Haellsigh/Bluetrackr/README.md

# Bluetrackr

Bluetrackr is a head tracking device. It allows you to track your head orientation & position in realtime. It's mainly used in games such as Elite Dangerous, Star Citizen, Flight simulators, etc to simulate head movement in a cockpit.

## Progress
prototype-v1: There was an unknown problem with the SPI bus. Might be because there are two devices on the same SPI bus?
prototype-v2: Ordered, waiting for parts.

Everything below is for v2.

### Transmitter schematic:



### Transmitter PCB:

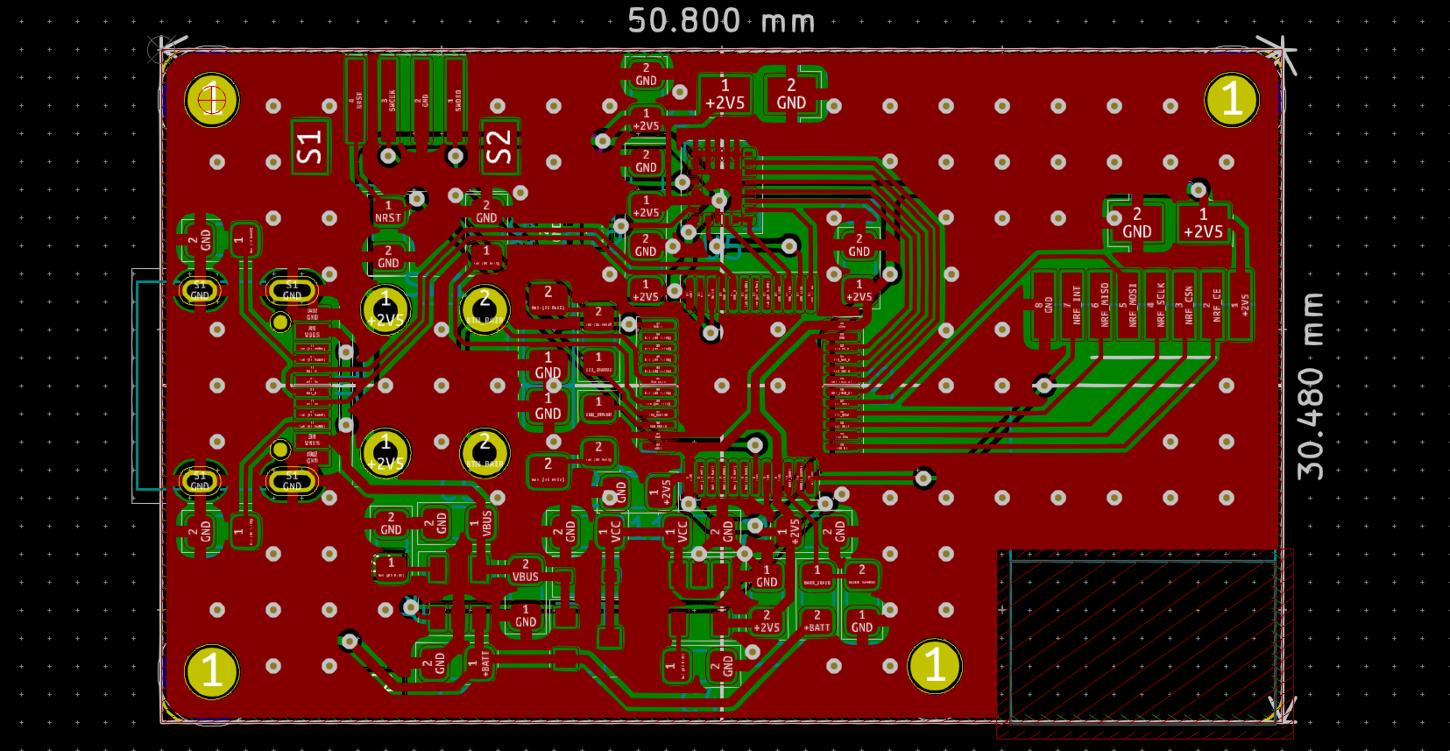
[picture p1: doc/images/Bluetrackr-transmitter-pcb.png]


### Transmitter PCB 3D view:

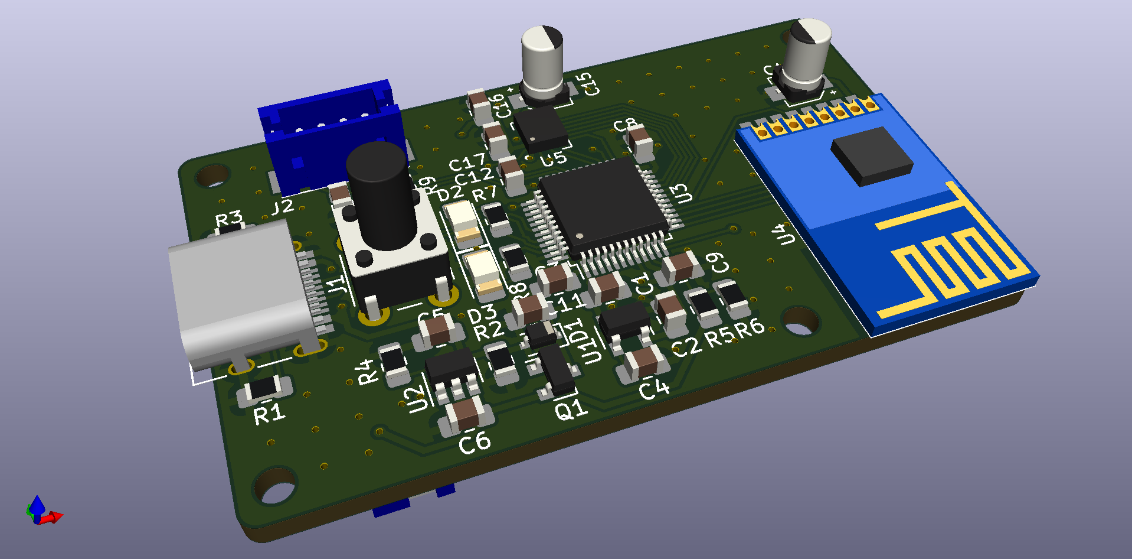
[picture p2: doc/images/Bluetrackr-transmitter-3d.png]


## Prototypes

#### Soldered prototype-v1
<p align="center">
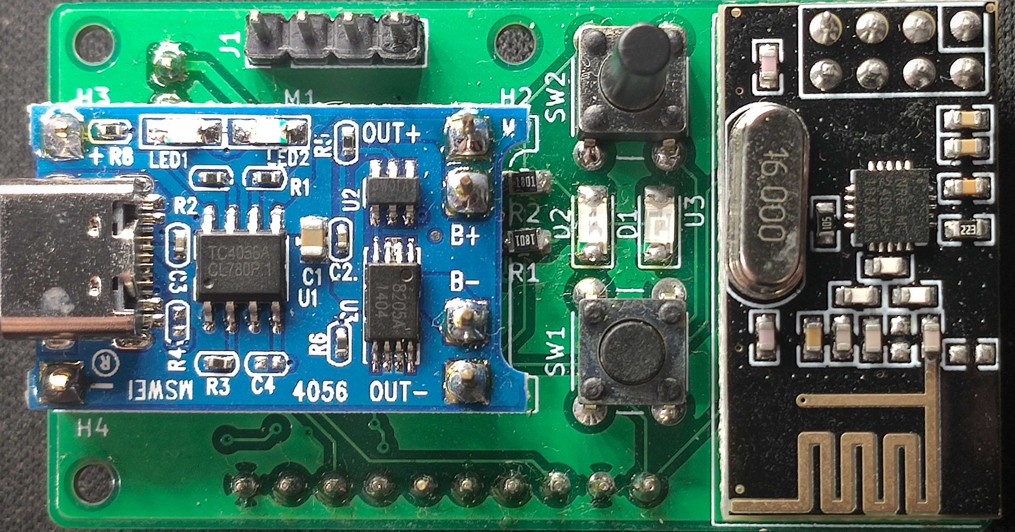
[picture p3: doc/images/transmitter_boards/v1-front.jpg]
  
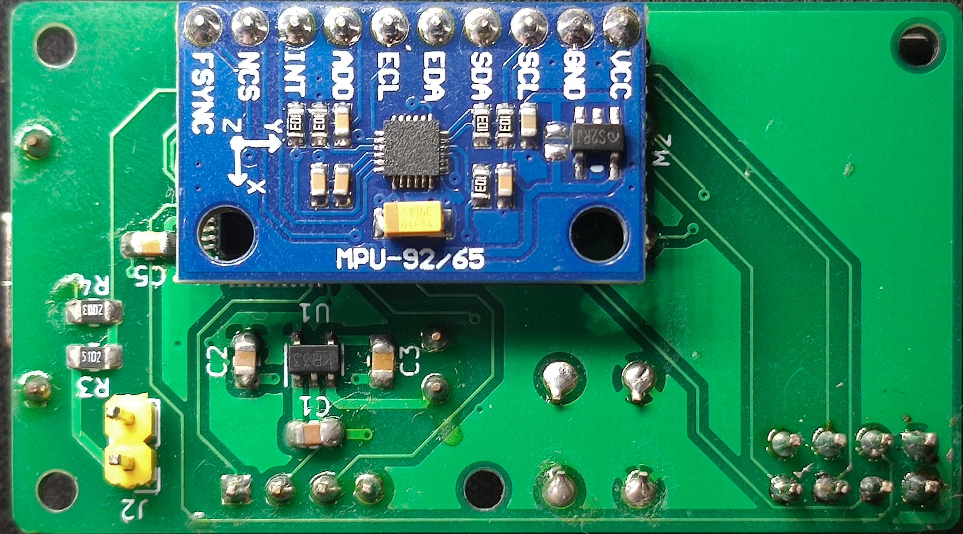
[picture p4: doc/images/transmitter_boards/v1-back.jpg]
  
</p>

#### Board prototype-v2
<p align="center">
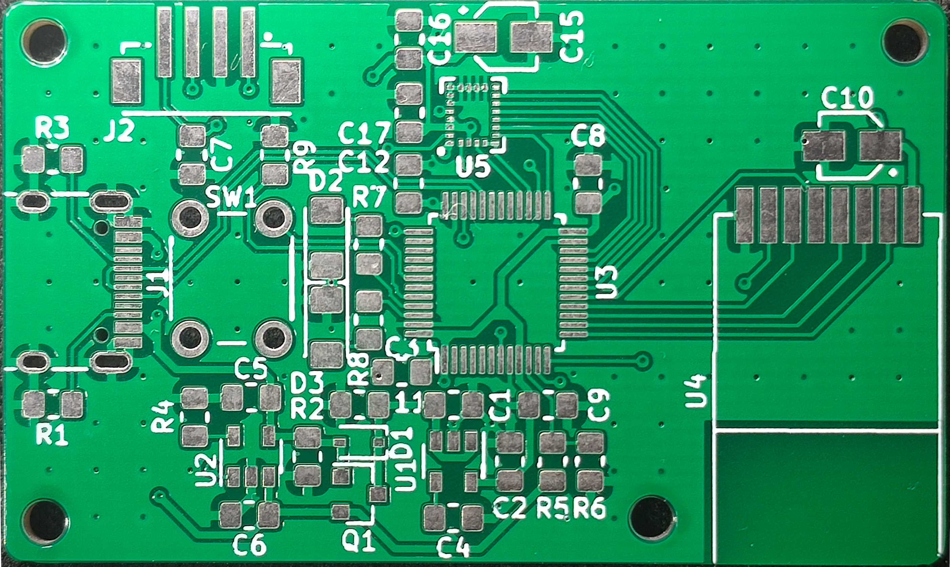
[picture p5: doc/images/transmitter_boards/v2-front.jpg]
  
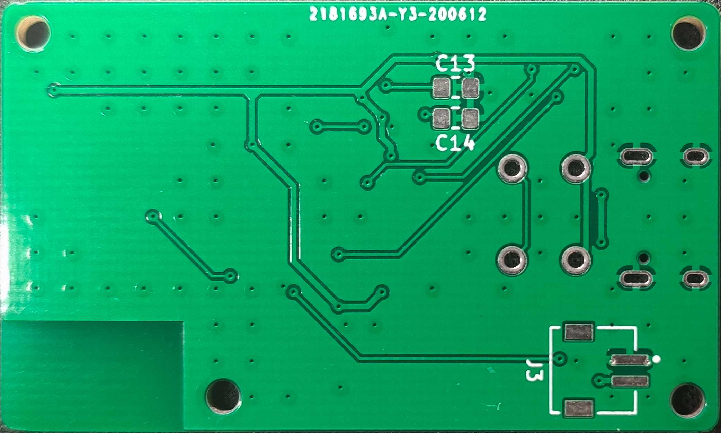
[picture p6: doc/images/transmitter_boards/v2-back.jpg]
  
</p>
