Haellsigh/Bluetrackr/(list of files, cad)

Other CAD files:
hardware/transmitter/case/Bluetrackr-transmitter-assembly.prt
hardware/transmitter/case/Bluetrackr-transmitter-case-bottom.prt
hardware/transmitter/case/Bluetrackr-transmitter-case-top.prt
