Haellsigh/Bluetrackr/hardware/transmitter/Bluetrackr-transmitter.kicad_pcb

## KiCad design hardware/transmitter/Bluetrackr-transmitter.kicad_pcb (2020-12-21)

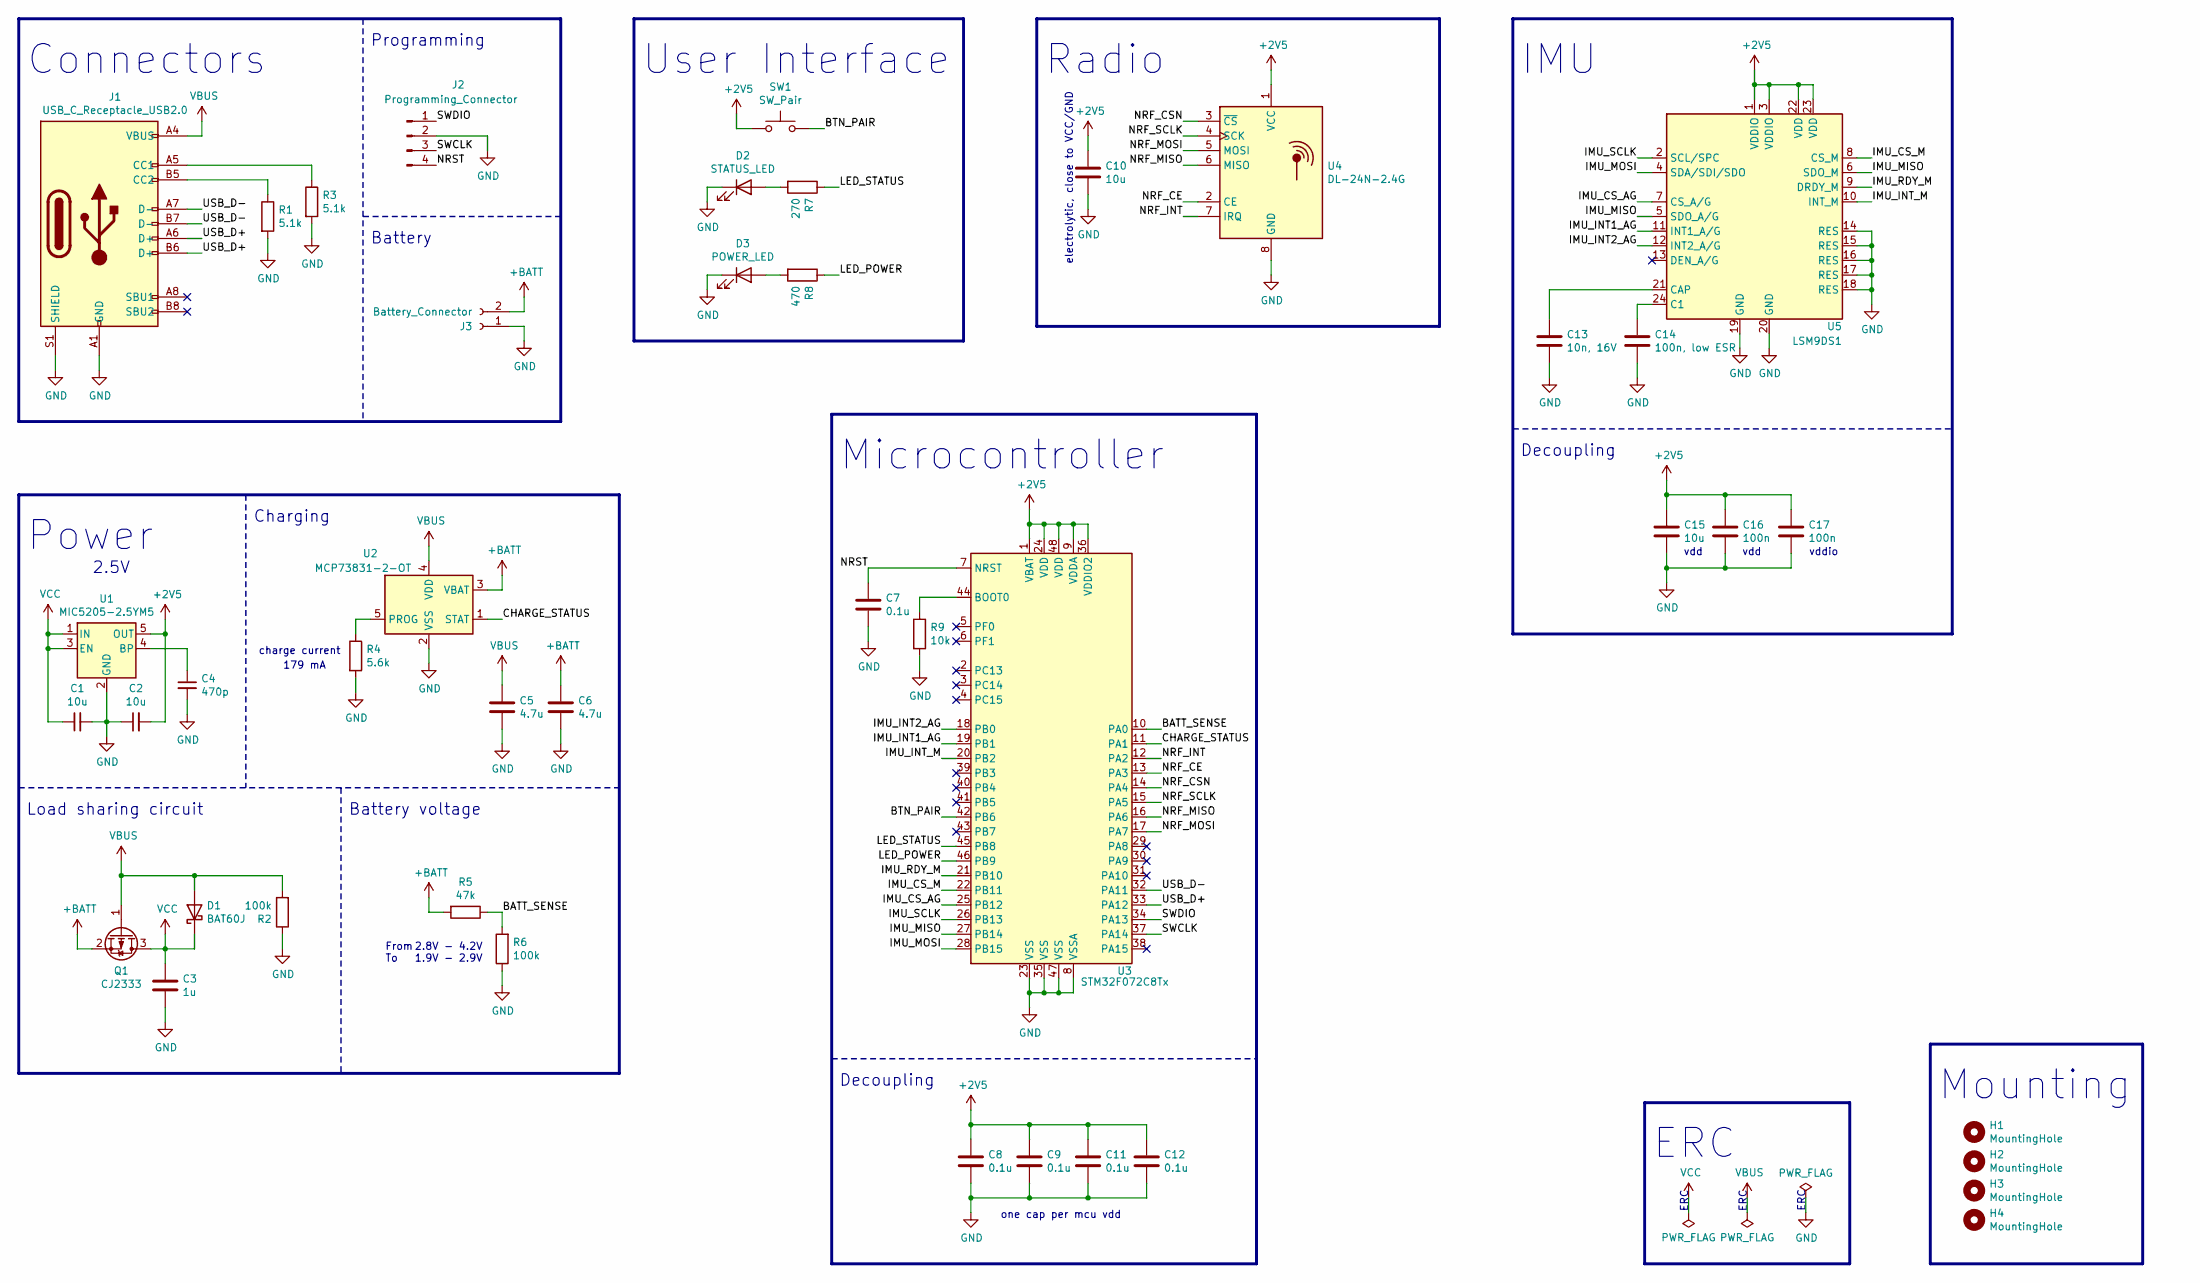
[picture p7: schematic Bluetrackr-transmitter.kicad_sch]

Parts:
C1, C2: 10u; C_0805_2012Metric_Pad1.15x1.40mm_HandSolder
C3: 1u; C_0805_2012Metric_Pad1.15x1.40mm_HandSolder
C4: 470p; C_0805_2012Metric_Pad1.15x1.40mm_HandSolder
C5, C6: 4.7u; C_0805_2012Metric_Pad1.15x1.40mm_HandSolder
C7, C8, C9, C11, C12: 0.1u; C_0805_2012Metric_Pad1.15x1.40mm_HandSolder
C10, C15: 10u; CP_Elec_3x5.3
C13: 10n, 16V; C_0805_2012Metric_Pad1.15x1.40mm_HandSolder
C14: 100n, low ESR; C_0805_2012Metric_Pad1.15x1.40mm_HandSolder
C16, C17: 100n; C_0805_2012Metric_Pad1.15x1.40mm_HandSolder
D1: BAT60J; D_SOD-323
D2: STATUS_LED; LED_1206_3216Metric_Pad1.42x1.75mm_HandSolder
D3: POWER_LED; LED_1206_3216Metric_Pad1.42x1.75mm_HandSolder
H1, H2, H3, H4: MountingHole; MountingHole_2.2mm_M2
J1: USB_C_Receptacle_USB2.0; USB_C_Receptacle_HRO_TYPE-C-31-M-12
J2: Programming_Connector; JST_B4B-ZR-SM4-TF
J3: Battery_Connector; JST_S2B-ZR-SM4A-TF
Q1: CJ2333; SOT-23
R1, R3: 5.1k; R_0805_2012Metric_Pad1.15x1.40mm_HandSolder
R2, R6: 100k; R_0805_2012Metric_Pad1.15x1.40mm_HandSolder
R4: 5.6k; R_0805_2012Metric_Pad1.15x1.40mm_HandSolder
R5: 47k; R_0805_2012Metric_Pad1.15x1.40mm_HandSolder
R7: 270; R_0805_2012Metric_Pad1.15x1.40mm_HandSolder
R8: 470; R_0805_2012Metric_Pad1.15x1.40mm_HandSolder
R9: 10k; R_0805_2012Metric_Pad1.15x1.40mm_HandSolder
SW1: SW_Pair; SW_PUSH_6mm_H9.5mm
U1: MIC5205-2.5YM5; SOT-23-5
U2: MCP73831-2-OT; SOT-23-5
U3: STM32F072C8Tx; LQFP-48_7x7mm_P0.5mm
U4: DL-24N-2.4G
U5: LSM9DS1; LGA-24L_3x3.5mm_P0.43mm

Connections:
+2V5: C2.2, C8.1, C9.1, C10.1, C11.1, C12.1, C15.1, C16.1, C17.1, SW1.1, U1.5 (OUT), U3.1 (VBAT), U3.9 (VDDA), U3.24 (VDD), U3.36 (VDDIO2), U3.48 (VDD), U4.1 (VCC), U5.1 (VDDIO), U5.3 (VDDIO), U5.22 (VDD), U5.23 (VDD)
+BATT: C6.1, J3.2, Q1.2 (S), R5.2, U2.3 (VBAT)
/BATT_SENSE: R5.1, R6.2, U3.10 (PA0)
/BTN_PAIR: SW1.2, U3.42 (PB6)
/CHARGE_STATUS: U2.1 (STAT), U3.11 (PA1)
/IMU_CS_AG: U3.25 (PB12), U5.7 (CS_A/G)
/IMU_CS_M: U3.22 (PB11), U5.8 (CS_M)
/IMU_INT1_AG: U3.19 (PB1), U5.11 (INT1_A/G)
/IMU_INT2_AG: U3.18 (PB0), U5.12 (INT2_A/G)
/IMU_INT_M: U3.20 (PB2), U5.10 (INT_M)
/IMU_MISO: U3.27 (PB14), U5.5 (SDO_A/G), U5.6 (SDO_M)
/IMU_MOSI: U3.28 (PB15), U5.4 (SDA/SDI/SDO)
/IMU_RDY_M: U3.21 (PB10), U5.9 (DRDY_M)
/IMU_SCLK: U3.26 (PB13), U5.2 (SCL/SPC)
/LED_POWER: R8.1, U3.46 (PB9)
/LED_STATUS: R7.1, U3.45 (PB8)
/NRF_CE: U3.13 (PA3), U4.2 (CE)
/NRF_CSN: U3.14 (PA4), U4.3 (~CS)
/NRF_INT: U3.12 (PA2), U4.7 (IRQ)
/NRF_MISO: U3.16 (PA6), U4.6 (MISO)
/NRF_MOSI: U3.17 (PA7), U4.5 (MOSI)
/NRF_SCLK: U3.15 (PA5), U4.4 (SCK)
/NRST: C7.1, J2.4, U3.7 (NRST)
/SWCLK: J2.3, U3.37 (PA14)
/SWDIO: J2.1, U3.34 (PA13)
/USB_D+: J1.A6 (D+), J1.B6 (D+), U3.33 (PA12)
/USB_D-: J1.A7 (D-), J1.B7 (D-), U3.32 (PA11)
GND: C1.2, C2.1, C3.2, C4.2, C5.2, C6.2, C7.2, C8.2, C9.2, C10.2, C11.2, C12.2, C13.2, C14.2, C15.2, C16.2, C17.2, D2.1 (K), D3.1 (K), J1.A1 (GND), J1.A12 (GND), J1.B1 (GND), J1.B12 (GND), J1.S1 (SHIELD), J2.2, J3.1, R1.2, R2.1, R3.2, R4.2, R6.1, R9.2, U1.2 (GND), U2.2 (VSS), U3.8 (VSSA), U3.23 (VSS), U3.35 (VSS), U3.47 (VSS), U4.8 (GND), U5.14 (RES), U5.15 (RES), U5.16 (RES), U5.17 (RES), U5.18 (RES), U5.19 (GND), U5.20 (GND)
unnamed: C4.1, U1.4 (BP)
unnamed: C13.1, U5.21 (CAP)
unnamed: C14.1, U5.24 (C1)
unnamed: D2.2 (A), R7.2
unnamed: D3.2 (A), R8.2
unnamed: J1.A5 (CC1), R3.1
unnamed: J1.B5 (CC2), R1.1
unnamed: R4.1, U2.5 (PROG)
unnamed: R9.1, U3.44 (BOOT0)
VBUS: C5.1, D1.2 (A), J1.A4 (VBUS), J1.A9 (VBUS), J1.B4 (VBUS), J1.B9 (VBUS), Q1.1 (G), R2.2, U2.4 (VDD)
VCC: C1.1, C3.1, D1.1 (K), Q1.3 (D), U1.1 (IN), U1.3 (EN)

Notes on the sheet:
Connectors
Power
Load sharing circuit
2.5V
Charging
179 mA
charge current
Battery voltage
Programming
Battery
From To
2.8V - 4.2V 1.9V - 2.9V
User Interface
Microcontroller
Decoupling
one cap per mcu vdd
Radio
electrolytic, close to VCC/GND
IMU
ERC
vdd
vddio
Mounting

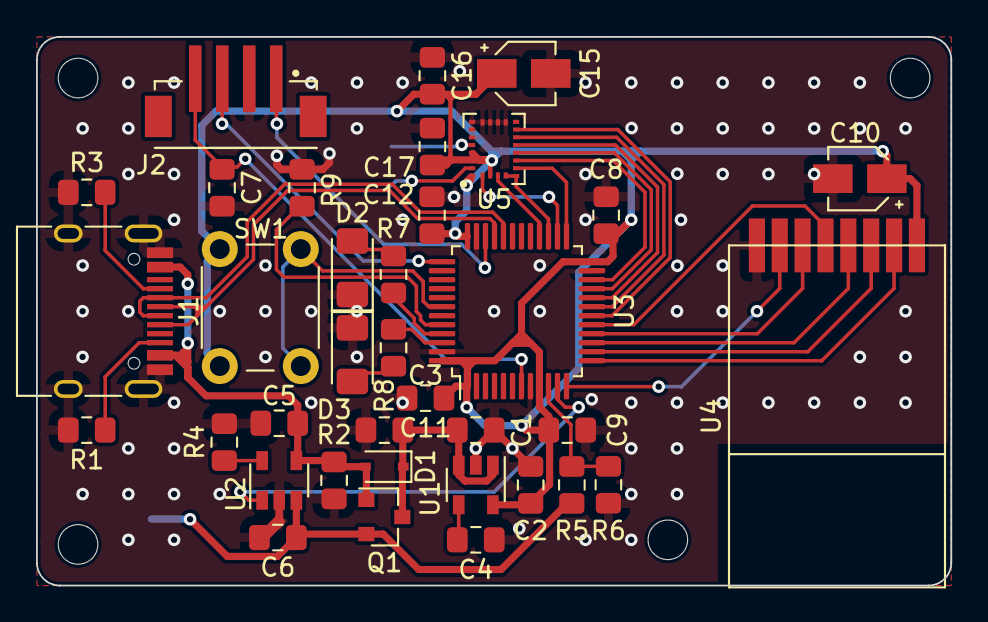
[picture p8: board Bluetrackr-transmitter.kicad_pcb from above]

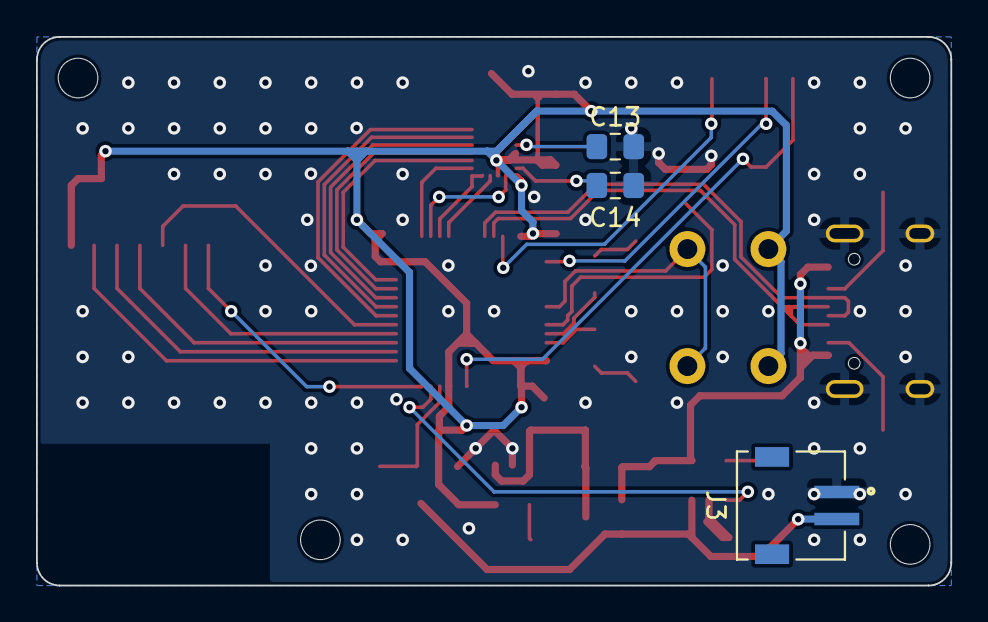
[picture p9: board Bluetrackr-transmitter.kicad_pcb from below]

Board: 2 copper layers, 50.8 x 30.5 mm, 43 parts (3 on the bottom side), 39 nets.
