Haellsigh/Bluetrackr/firmware/transmitter/inc/main.h

#define BATT_SENSE_Pin GPIO_PIN_0
#define BATT_SENSE_GPIO_Port GPIOA
#define CHARGE_STATUS_Pin GPIO_PIN_1
#define CHARGE_STATUS_GPIO_Port GPIOA
#define NRF_INT_Pin GPIO_PIN_2
#define NRF_INT_GPIO_Port GPIOA
#define NRF_CE_Pin GPIO_PIN_3
#define NRF_CE_GPIO_Port GPIOA
#define NRF_CSN_Pin GPIO_PIN_4
#define NRF_CSN_GPIO_Port GPIOA
#define NRF_SCLK_Pin GPIO_PIN_5
#define NRF_SCLK_GPIO_Port GPIOA
#define NRF_MISO_Pin GPIO_PIN_6
#define NRF_MISO_GPIO_Port GPIOA
#define NRF_MOSI_Pin GPIO_PIN_7
#define NRF_MOSI_GPIO_Port GPIOA
#define IMU_RDY_M_Pin GPIO_PIN_10
#define IMU_RDY_M_GPIO_Port GPIOB
#define IMU_CS_M_Pin GPIO_PIN_11
#define IMU_CS_M_GPIO_Port GPIOB
#define IMU_CS_AG_Pin GPIO_PIN_12
#define IMU_CS_AG_GPIO_Port GPIOB
#define IMU_SCLK_Pin GPIO_PIN_13
#define IMU_SCLK_GPIO_Port GPIOB
#define IMU_MISO_Pin GPIO_PIN_14
#define IMU_MISO_GPIO_Port GPIOB
#define IMU_MOSI_Pin GPIO_PIN_15
#define IMU_MOSI_GPIO_Port GPIOB
#define BTN_PAIR_Pin GPIO_PIN_6
#define BTN_PAIR_GPIO_Port GPIOB
#define LED_STATUS_Pin GPIO_PIN_8
#define LED_STATUS_GPIO_Port GPIOB
#define LED_POWER_Pin GPIO_PIN_9
#define LED_POWER_GPIO_Port GPIOB
