Haellsigh/Bluetrackr/(commit log)

2019-10-16 Add transmitter hardware project
    [Bluetrackr-transmitter.kicad_pcb, Bluetrackr-transmitter.sch]
2019-10-16 Remove pull down resistor on button
    [Bluetrackr-transmitter.sch]
2019-10-16 Finish transmitter schematic, pass DRC
    [Bluetrackr-transmitter.sch]
2019-10-16 Layout the transmitter pcb
    [Bluetrackr-transmitter.kicad_pcb, Bluetrackr-transmitter.sch]
2019-10-16 Update PCB rules
    [Bluetrackr-transmitter.kicad_pcb]
2019-10-16 Begin routing transmitter pcb
    [Bluetrackr-transmitter.kicad_pcb]
2019-10-17 Finished transmitter routing
    [Bluetrackr-transmitter.kicad_pcb]
2019-10-18 First working test: read MPU9250 values & output to serial
    [Bluetrackr-transmitter.kicad_pcb]
2019-11-05 Begin receiver schematic
    [Bluetrackr-receiver.kicad_pcb, Bluetrackr-receiver.sch, Bluetrackr-transmitter.sch]
2019-11-21 Received, assembled, programmed the first working prototype of the transmitter
2019-11-24 Replace global labels with net labels
    [Bluetrackr-transmitter.sch]
2019-11-24 Replace the unused programming pin with NRST to support stlink reset
    [Bluetrackr-transmitter.sch]
2019-12-06 Moved the common libraries to a common folder
    [Bluetrackr-transmitter.kicad_pcb]
2019-12-20 Fix nRF24 implementation a bit, still not working
    [main_loop.cpp, nrf24_impl.hpp]
2020-01-17 Update transmitter schematic
    [Bluetrackr-transmitter.sch, Charging.sch]
2020-05-31 Use CMake to build the firmware
    [Bluetrackr-transmitter.sch]
2020-06-02 The current hardware doesn't seem to work
    [Bluetrackr-transmitter.ioc, main_loop.cpp]
2020-06-04 Redesign most of the transmitter hardware
    Changes:
    - Switch to KiCad 6 files
    - Change microcontroller to STM32F030R8T6
    - Use two SPI buses, one for each device
    - Replace TP4056 module for a custom solution with:
    - USB Type-C USB 2.0 receptacle
    - MCP73831 based LiPo charger
    - Load sharing circuit to allow charging while using the device
    - Charge status and battery voltage sensing
    - Replace MPU9250 module for a custom solution with:
    - Modern ICM-20948 9 axis imu
    - 1.8V regulator
    - Voltage level shifting for SPI and interrupt from 3.3V to 1.8V (should be good up to 8Mhz)
    - Change the programming connector to include reset function. Pins are now SWDIO, GND, SWCLK, NRST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
    [Bluetrackr-receiver.kicad_pcb, Bluetrackr-receiver.kicad_sch, Bluetrackr-receiver.sch, Bluetrackr-transmitter.kicad_sch, Bluetrackr-transmitter.sch, Charging.sch]
2020-06-04 Remove changelog for now
    [Bluetrackr-transmitter.kicad_sch]
2020-06-04 Fix not connected errors on ERC
    [Bluetrackr-transmitter.kicad_sch]
2020-06-04 Add board basic dimensions 5x3cm
    [Bluetrackr-transmitter.kicad_pcb, Bluetrackr-transmitter.kicad_sch]
2020-06-04 Rename schematic file
2020-06-04 Crop transmitter schematic
2020-06-04 Plot transmitter schematic again
2020-06-04 Update transmitter schematic pdf
2020-06-04 Change level shifting resistors to 10k
    [Bluetrackr-transmitter.kicad_sch]
2020-06-04 Add transmitter schematic
2020-06-04 Changed regulator from 3.3V to 2.5V
    [Bluetrackr-transmitter.kicad_sch]
2020-06-10 Began routing the pcb
    [Bluetrackr-transmitter.kicad_pcb, Bluetrackr-transmitter.kicad_sch]
2020-06-10 Replace nRF24 breakout with DL-24N nRF24 smd module
    [Bluetrackr-transmitter.kicad_pcb, Bluetrackr-transmitter.kicad_sch]
2020-06-10 Replace ICM-20948 with LSM9DS1, removes 1.8V supply and level shifters
    [Bluetrackr-transmitter.kicad_sch]
2020-06-10 Annotate schematic
    [Bluetrackr-transmitter.kicad_sch]
2020-06-10 Remove pcb
    [Bluetrackr-transmitter.kicad_pcb, Bluetrackr-transmitter.kicad_sch]
2020-06-10 Finish schematic with new Radio & IMU
    [Bluetrackr-transmitter.kicad_sch]
2020-06-10 Place mounting holes, usb connector, mcu and radio
2020-06-10 Setup board rules
2020-06-10 Move mounting holes silkscreen to fab layer
2020-06-10 Changed MCU to IMU pins
    [Bluetrackr-transmitter.kicad_sch]
2020-06-10 Placed MCU and IMU
2020-06-10 Change MCU to STM32F072C8T6 for USB
    [Bluetrackr-transmitter.kicad_sch]
2020-06-10 Reset and run bugged KiCad 5.99 ERC
2020-06-10 Add basic transmitter pcb with main ICs laid
    [Bluetrackr-transmitter.kicad_pcb]
2020-06-10 Place Power components
    [Bluetrackr-transmitter.kicad_pcb]
2020-06-11 Place CC1 and CC2 for USB
    [Bluetrackr-transmitter.kicad_pcb]
2020-06-11 Place LEDs
    [Bluetrackr-transmitter.kicad_pcb, Bluetrackr-transmitter.kicad_sch]
2020-06-11 Place BOOT0 resistor
    [Bluetrackr-transmitter.kicad_pcb]
2020-06-11 Change connectors to ZH SMD versions
    [Bluetrackr-transmitter.kicad_pcb, Bluetrackr-transmitter.kicad_sch]
2020-06-11 Add 3D models to JST ZH connectors
    [Bluetrackr-transmitter.kicad_pcb]
2020-06-11 Begin routing
    [Bluetrackr-transmitter.kicad_pcb, Bluetrackr-transmitter.kicad_sch]
2020-06-11 Routed USB, SPI tracks
    [Bluetrackr-transmitter.kicad_pcb]
2020-06-11 Finish routing the transmitter, add DL-24N module step file
    [Bluetrackr-transmitter.kicad_pcb]
2020-06-11 Correct some power traces
    [Bluetrackr-transmitter.kicad_pcb]
2020-06-11 Moved IMU interrupt lines further away
    [Bluetrackr-transmitter.kicad_pcb]
2020-06-11 Final PCB, ordered at JLCPCB
2020-06-11 Reset solder mask clearancec
    [Bluetrackr-transmitter.kicad_pcb]
2020-06-11 Plot gerbers and drill files
    [Bluetrackr-transmitter.kicad_pcb]
2020-06-11 Update plot settings
    [Bluetrackr-transmitter.kicad_pcb]
2020-06-12 Update schematic
2020-06-12 Update README images
    [Bluetrackr-transmitter.kicad_pcb, Bluetrackr-transmitter.kicad_sch]
2020-06-12 Switch target to F103 bluepill and add USB CDC
2020-06-14 Add simple debug library for F303K8 via VCP UART
2020-06-14 Switched receiver to Platformio
2020-06-15 Fix nRF24 code on transmitter side
    [main.h, main_loop.cpp, nrf24_impl.hpp, transmitter.ioc]
2020-06-18 Add transmitter board v1 and v2 images
2020-06-18 Update readme with prototypes
2020-06-26 Finish typesafe version prototype of the nRF24 library
2020-06-26 Fixed a pin toggling error in blt::gpio
    [main_loop.cpp, transmitter.ioc]
2020-07-05 Commit before prototype programming
2020-07-07 Add HID joystick driver base
2020-09-01 Update KiCad version
    [Bluetrackr-transmitter.kicad_pcb]
2020-09-01 Setup USB DFU updates on the transmitter on button press
2020-09-06 Describe all the lsm9ds1 accel and gyro registers using a new typesafe method
2020-09-08 Finished base lsm9ds1 library with a working wireless transmission of acc & gyro data
2020-11-16 Big update I forgot to push...
    [Bluetrackr-transmitter-assembly.prt, Bluetrackr-transmitter-case-bottom.prt, Bluetrackr-transmitter-case-top.prt]
2020-12-21 Update formatting of kicad files
    [Bluetrackr-transmitter.kicad_pcb]
